rweather/ardpicprog/circuits/pic14_zif_assembled.jpg

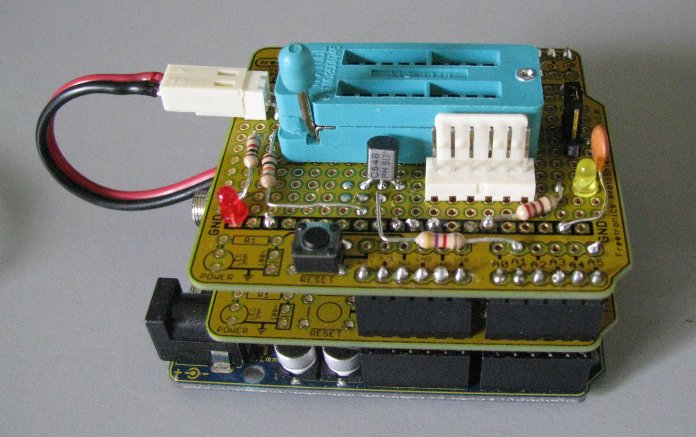
circuits/pic14_zif_assembled.jpg
