rweather/ardpicprog/circuits/eeprom_circuit_inuse.jpg

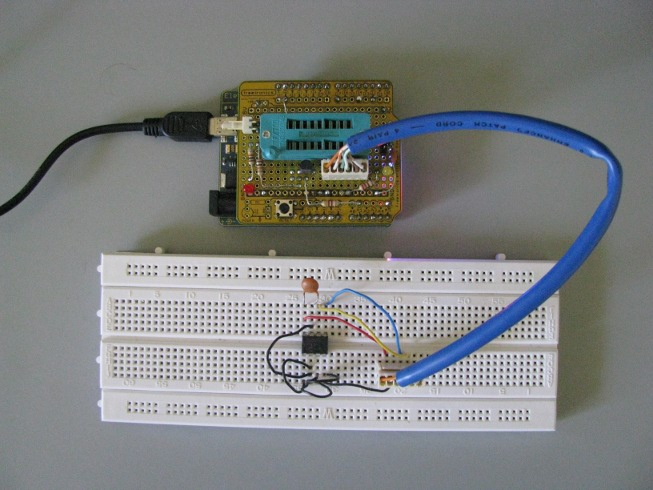
circuits/eeprom_circuit_inuse.jpg
