rweather/ardpicprog/circuits/eeprom_circuit.pdf

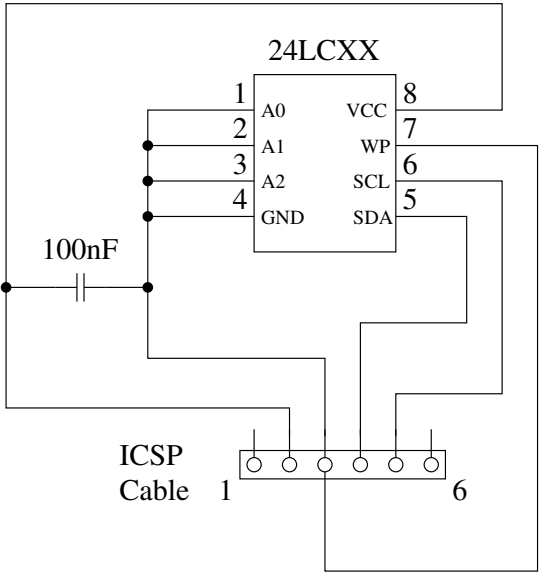
[picture p3: figure]
GND; VCC; SCL; SDA; 24LCXX; ICSP Cable

Description

MCLR/VPP

VDD

VSS

DATA

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
ICSP
