rweather/ardpicprog/circuits/eeprom_circuit.png

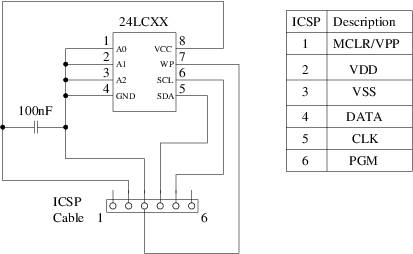
circuits/eeprom_circuit.png
