rweather/ardpicprog/circuits/icsp_circuit.png

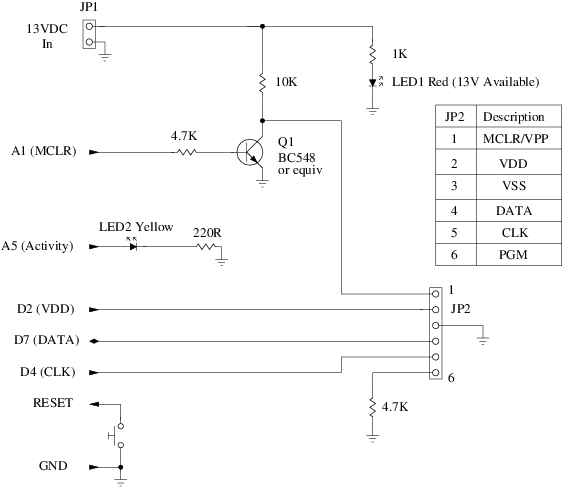
circuits/icsp_circuit.png
