rweather/ardpicprog/circuits/pic14_zif_bottom.jpg

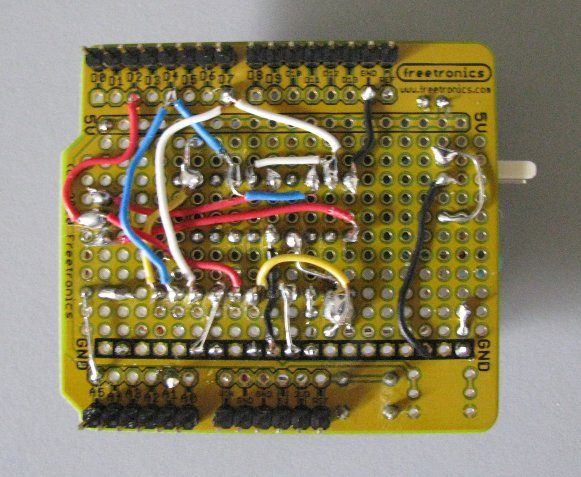
circuits/pic14_zif_bottom.jpg
