rweather/ardpicprog/circuits/pic14_zif_circuit.png

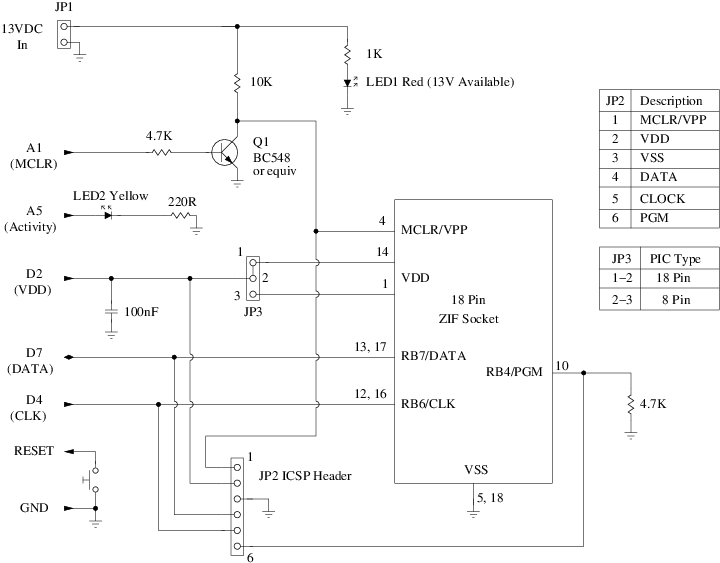
circuits/pic14_zif_circuit.png
