rweather/ardpicprog/circuits/pic14_zif_inuse.jpg

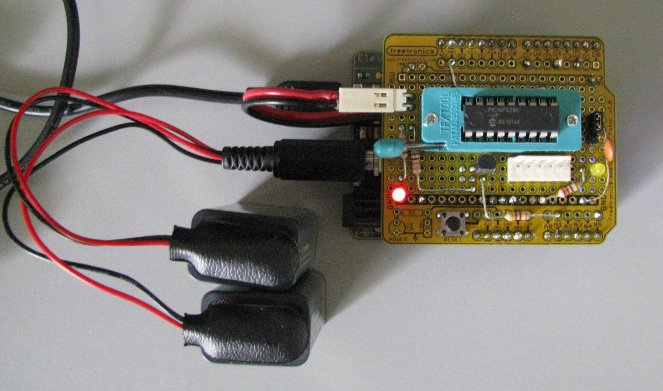
circuits/pic14_zif_inuse.jpg
