rweather/ardpicprog/circuits/pic14_zif_top.jpg

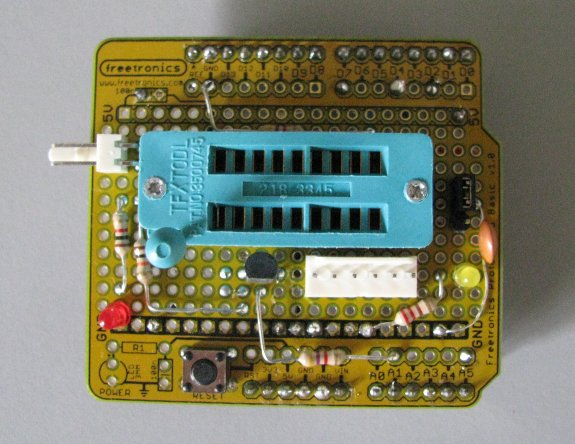
circuits/pic14_zif_top.jpg
