rweather/ardpicprog/circuits/power_supply_batteries.jpg

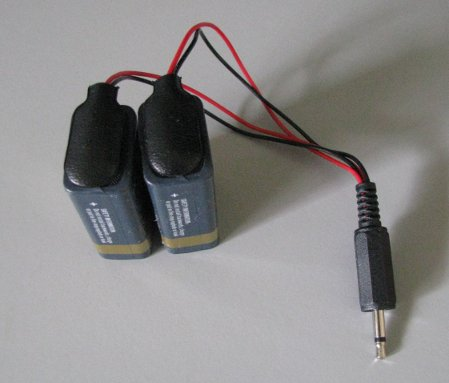
circuits/power_supply_batteries.jpg
