rweather/ardpicprog/circuits/power_supply_bottom.jpg

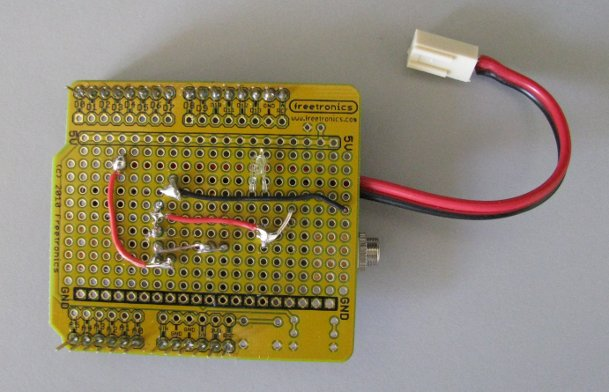
circuits/power_supply_bottom.jpg
