rweather/ardpicprog/circuits/power_supply_circuit.png

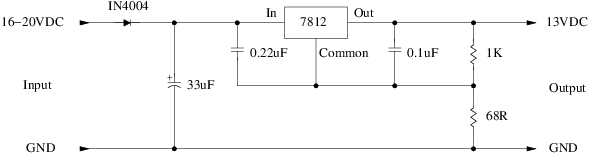
circuits/power_supply_circuit.png
