rweather/ardpicprog/circuits/power_supply_max629.png

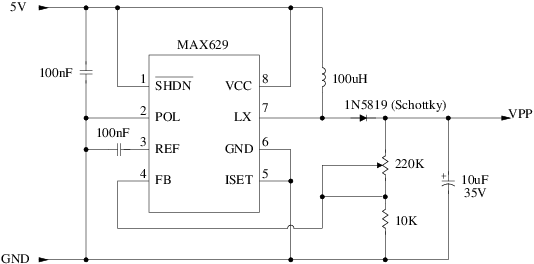
circuits/power_supply_max629.png
