rweather/ardpicprog/circuits/power_supply_mc34063.png

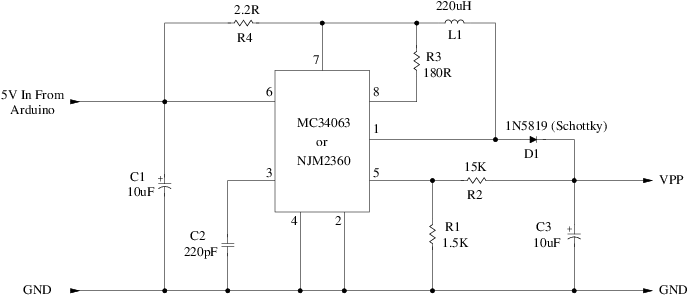
circuits/power_supply_mc34063.png
