rweather/ardpicprog/circuits/power_supply_mc34063_adjustable.png

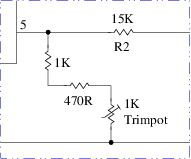
circuits/power_supply_mc34063_adjustable.png
