rweather/ardpicprog/circuits/power_supply_mc34063_breadboard.jpg

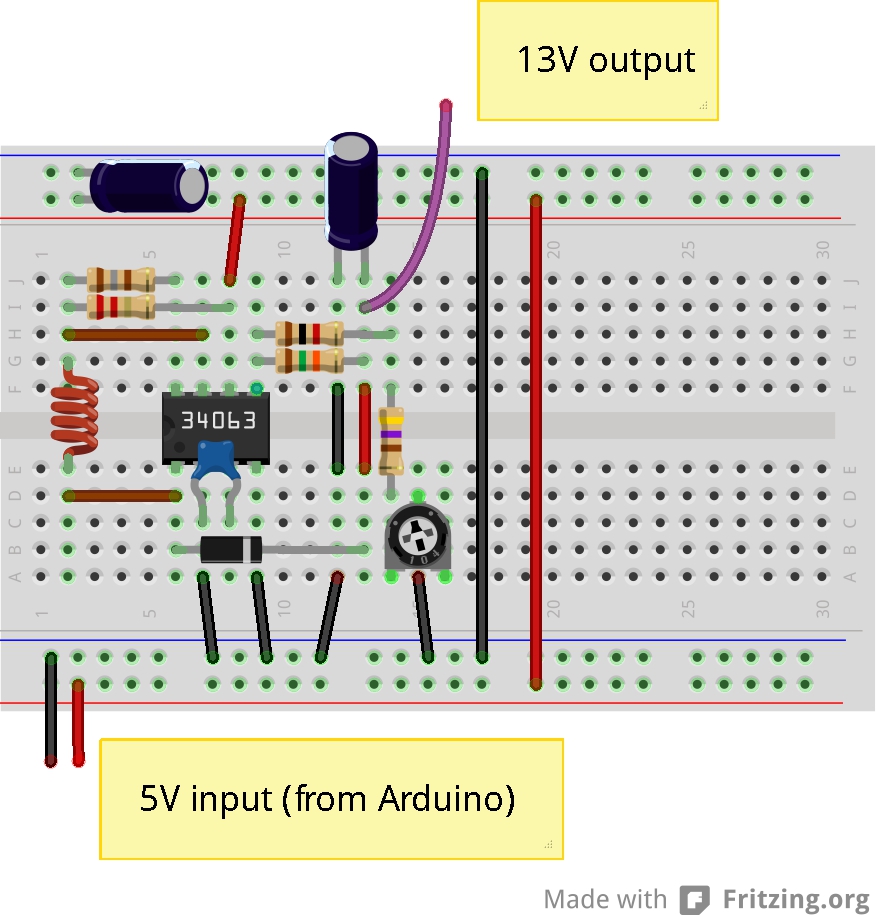
circuits/power_supply_mc34063_breadboard.jpg
