rweather/ardpicprog/circuits/power_supply_top.jpg

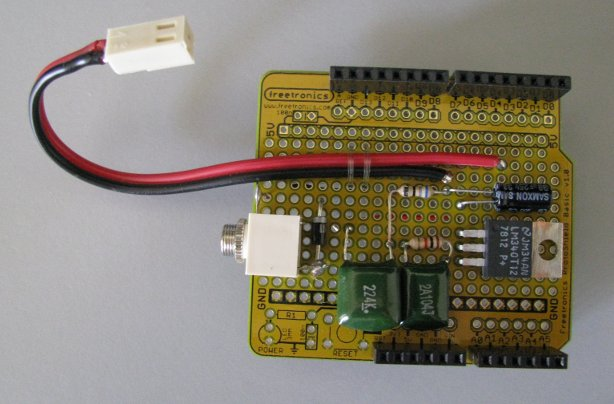
circuits/power_supply_top.jpg
