rweather/ardpicprog/ChangeLog.md

## Change log

### 0.1.1

* Native Win32 version of the serial port code.
* Stub manual page that redirects to the web documentation.
* Install and uninstall rules in the Makefiles.

### 0.1.0

* Initial version with support for common 14-bit PIC devices.
