rweather/ardpicprog/(threads)

Thread 1 (2013-05-05):

error @ arduino 1.0.1

tomaskovacik, 2013-05-05:
ardpicprog.cpp:69:28: error: ‘prog_char’ does not name a type
ardpicprog.cpp:69:39: error: ISO C++ forbids declaration of ‘str’ with no type [-fpermissive]
ardpicprog.cpp:86:24: error: ‘prog_char’ does not name a type
ardpicprog.cpp:86:35: error: ISO C++ forbids declaration of ‘name’ with no type [-fpermissive]
ardpicprog.cpp:144:11: error: ‘prog_char’ does not name a type
ardpicprog.cpp:145:5: error: ‘prog_int16_t’ does not name a type
ardpicprog.cpp:146:5: error: ‘prog_uint32_t’ does not name a type
ardpicprog.cpp:147:5: error: ‘prog_uint32_t’ does not name a type
ardpicprog.cpp:148:5: error: ‘prog_uint32_t’ does not name a type
ardpicprog.cpp:149:5: error: ‘prog_uint16_t’ does not name a type
ardpicprog.cpp:150:5: error: ‘prog_uint16_t’ does not name a type
ardpicprog.cpp:151:5: error: ‘prog_uint16_t’ does not name a type
ardpicprog.cpp:152:5: error: ‘prog_uint16_t’ does not name a type
ardpicprog.cpp:153:5: error: ‘prog_uint8_t’ does not name a type
ardpicprog.cpp:154:5: error: ‘prog_uint8_t’ does not name a type
ardpicprog.cpp:181:1: error: too many initializers for ‘const deviceInfo’
ardpicprog.cpp:181:1: error: too many initializers for ‘const deviceInfo’
ardpicprog.cpp:181:1: error: too many initializers for ‘const deviceInfo’
ardpicprog.cpp:181:1: error: too many initializers for ‘const deviceInfo’
ardpicprog.cpp:181:1: error: too many initializers for ‘const deviceInfo’
ardpicprog.cpp:181:1: error: too many initializers for ‘const deviceInfo’
ardpicprog.cpp:181:1: error: too many initializers for ‘const deviceInfo’
ardpicprog.cpp:181:1: error: too many initializers for ‘const deviceInfo’
ardpicprog.cpp:181:1: error: too many initializers for ‘const deviceInfo’
ardpicprog.cpp:181:1: error: too many initializers for ‘const deviceInfo’
ardpicprog.cpp:181:1: error: too many initializers for ‘const deviceInfo’
ardpicprog.cpp:181:1: error: too many initializers for ‘const deviceInfo’
ardpicprog.cpp:181:1: error: too many initializers for ‘const deviceInfo’
ardpicprog.cpp:181:1: error: too many initializers for ‘const deviceInfo’
ardpicprog.cpp:271:28: error: ‘prog_char’ does not name a type
ardpicprog.cpp:271:39: error: ISO C++ forbids declaration of ‘str’ with no type [-fpermissive]
ardpicprog.cpp: In function ‘void initDevice(const deviceInfo_)’:
ardpicprog.cpp:293:18: error: ‘const struct deviceInfo’ has no member named ‘programSize’
ardpicprog.cpp:294:19: error: ‘const struct deviceInfo’ has no member named ‘configStart’
ardpicprog.cpp:295:31: error: ‘const struct deviceInfo’ has no member named ‘configSize’
ardpicprog.cpp:296:17: error: ‘const struct deviceInfo’ has no member named ‘dataStart’
ardpicprog.cpp:297:27: error: ‘const struct deviceInfo’ has no member named ‘dataSize’
ardpicprog.cpp:298:34: error: ‘const struct deviceInfo’ has no member named ‘reservedWords’
ardpicprog.cpp:300:18: error: ‘const struct deviceInfo’ has no member named ‘configSave’
ardpicprog.cpp:301:21: error: ‘const struct deviceInfo’ has no member named ‘progFlashType’
ardpicprog.cpp:302:21: error: ‘const struct deviceInfo’ has no member named ‘dataFlashType’
ardpicprog.cpp:306:28: error: ISO C++ forbids declaration of ‘type name’ with no type [-fpermissive]
ardpicprog.cpp:306:28: error: ISO C++ forbids declaration of ‘type name’ with no type [-fpermissive]
ardpicprog.cpp:306:22: error: expected primary-expression before ‘const’
ardpicprog.cpp:306:22: error: expected ‘)’ before ‘const’
ardpicprog.cpp:306:41: error: expected ‘;’ before ‘)’ token
ardpicprog.cpp: In function ‘void cmdDevice(const char_)’:
ardpicprog.cpp:393:15: error: ‘prog_char’ does not name a type
ardpicprog.cpp:394:14: error: expected primary-expression before ‘)’ token
ardpicprog.cpp:394:14: error: expected ‘;’ before ‘)’ token
ardpicprog.cpp:395:14: error: ‘name’ was not declared in this scope
ardpicprog.cpp:399:18: error: ‘const struct deviceInfo’ has no member named ‘deviceId’
ardpicprog.cpp: In function ‘void cmdDevices(const char_)’:
ardpicprog.cpp:437:15: error: ‘prog_char’ does not name a type
ardpicprog.cpp:438:14: error: expected primary-expression before ‘)’ token
ardpicprog.cpp:438:14: error: expected ‘;’ before ‘)’ token
ardpicprog.cpp:439:14: error: ‘name’ was not declared in this scope
ardpicprog.cpp:448:25: error: ‘name’ was not declared in this scope
ardpicprog.cpp:449:24: error: ‘const struct deviceInfo’ has no member named ‘deviceId’
ardpicprog.cpp: In function ‘void cmdSetDevice(const char_)’:
ardpicprog.cpp:473:15: error: ‘prog_char’ does not name a type
ardpicprog.cpp:474:14: error: expected primary-expression before ‘)’ token
ardpicprog.cpp:474:14: error: expected ‘;’ before ‘)’ token
ardpicprog.cpp:475:14: error: ‘name’ was not declared in this scope
ardpicprog.cpp:477:25: error: ‘name’ was not declared in this scope
ardpicprog.cpp: In function ‘void cmdWrite(const char_)’:
ardpicprog.cpp:648:48: error: cannot convert ‘const char_’ to ‘const int_’ for argument ‘1’ to ‘bool matchString(const int_, const char_, int)’
ardpicprog.cpp: In function ‘void cmdWriteBinary(const char_)’:
ardpicprog.cpp:736:48: error: cannot convert ‘const char_’ to ‘const int_’ for argument ‘1’ to ‘bool matchString(const int_, const char_, int)’
ardpicprog.cpp: In function ‘void cmdErase(const char_)’:
ardpicprog.cpp:837:57: error: cannot convert ‘const char_’ to ‘const int_’ for argument ‘1’ to ‘bool matchString(const int_, const char_, int)’
ardpicprog.cpp: At global scope:
ardpicprog.cpp:947:11: error: ‘prog_char’ does not name a type
ardpicprog.cpp:949:11: error: ‘prog_char’ does not name a type
ardpicprog.cpp:950:11: error: ‘prog_char’ does not name a type
ardpicprog.cpp:1002:1: error: too many initializers for ‘const command_t’
ardpicprog.cpp:1002:1: error: too many initializers for ‘const command_t’
ardpicprog.cpp:1002:1: error: too many initializers for ‘const command_t’
ardpicprog.cpp:1002:1: error: too many initializers for ‘const command_t’
ardpicprog.cpp:1002:1: error: too many initializers for ‘const command_t’
ardpicprog.cpp:1002:1: error: too many initializers for ‘const command_t’
ardpicprog.cpp:1002:1: error: too many initializers for ‘const command_t’
ardpicprog.cpp:1002:1: error: too many initializers for ‘const command_t’
ardpicprog.cpp:1002:1: error: too many initializers for ‘const command_t’
ardpicprog.cpp:1002:1: error: too many initializers for ‘const command_t’
ardpicprog.cpp:1002:1: error: too many initializers for ‘const command_t’
ardpicprog.cpp:1002:1: error: too many initializers for ‘const command_t’
ardpicprog.cpp:1002:1: error: cannot convert ‘const char_’ to ‘commandFunc {aka void (_)(const char_)}’ in initialization
ardpicprog.cpp:1002:1: error: cannot convert ‘const char_’ to ‘commandFunc {aka void (_)(const char_)}’ in initialization
ardpicprog.cpp:1002:1: error: cannot convert ‘const char_’ to ‘commandFunc {aka void (_)(const char_)}’ in initialization
ardpicprog.cpp:1002:1: error: cannot convert ‘const char_’ to ‘commandFunc {aka void (_)(const char_)}’ in initialization
ardpicprog.cpp:1002:1: error: cannot convert ‘const char_’ to ‘commandFunc {aka void (_)(const char_)}’ in initialization
ardpicprog.cpp:1002:1: error: cannot convert ‘const char_’ to ‘commandFunc {aka void (_)(const char_)}’ in initialization
ardpicprog.cpp:1002:1: error: cannot convert ‘const char_’ to ‘commandFunc {aka void (_)(const char_)}’ in initialization
ardpicprog.cpp:1002:1: error: cannot convert ‘const char_’ to ‘commandFunc {aka void (_)(const char_)}’ in initialization
ardpicprog.cpp:1002:1: error: cannot convert ‘const char_’ to ‘commandFunc {aka void (_)(const char_)}’ in initialization
ardpicprog.cpp:1002:1: error: cannot convert ‘const char_’ to ‘commandFunc {aka void (_)(const char_)}’ in initialization
ardpicprog.cpp:1002:1: error: cannot convert ‘const char_’ to ‘commandFunc {aka void (_)(const char_)}’ in initialization
ardpicprog.cpp: In function ‘void cmdHelp(const char_)’:
ardpicprog.cpp:1010:15: error: ‘prog_char’ does not name a type
ardpicprog.cpp:1011:14: error: expected primary-expression before ‘)’ token
ardpicprog.cpp:1011:14: error: expected ‘;’ before ‘)’ token
ardpicprog.cpp:1012:14: error: ‘name’ was not declared in this scope
ardpicprog.cpp:1014:15: error: ‘prog_char’ does not name a type
ardpicprog.cpp:1015:14: error: expected primary-expression before ‘)’ token
ardpicprog.cpp:1015:14: error: expected ‘;’ before ‘)’ token
ardpicprog.cpp:1016:15: error: ‘prog_char’ does not name a type
ardpicprog.cpp:1017:14: error: expected primary-expression before ‘)’ token
ardpicprog.cpp:1017:14: error: expected ‘;’ before ‘)’ token
ardpicprog.cpp:1018:25: error: ‘name’ was not declared in this scope
ardpicprog.cpp:1021:33: error: cannot convert ‘const char_’ to ‘const int_’ for argument ‘1’ to ‘void printProgString(const int_)’
ardpicprog.cpp:1025:25: error: ‘desc’ was not declared in this scope
ardpicprog.cpp: At global scope:
ardpicprog.cpp:1033:24: error: ‘prog_char’ does not name a type
ardpicprog.cpp:1033:35: error: ISO C++ forbids declaration of ‘name’ with no type [-fpermissive]
ardpicprog.cpp: In function ‘void processCommand(const char*)’:
ardpicprog.cpp:1082:15: error: ‘prog_char’ does not name a type
ardpicprog.cpp:1083:14: error: expected primary-expression before ‘)’ token
ardpicprog.cpp:1083:14: error: expected ‘;’ before ‘)’ token
ardpicprog.cpp:1084:14: error: ‘name’ was not declared in this scope
ardpicprog.cpp:1086:25: error: ‘name’ was not declared in this scope

Closed 2018-08-30.

Thread 6 (2017-06-16):

Arduino 1.6.8 'prog_char' does not name a type

EnriqueMT92, 2017-06-16:
I am trying to compile the arduino pic programmer program and it gives me this error
'prog_char' does not name a type

adlerweb, 2018-02-10:
Duplicate of #1

Thread 8 (2019-08-05):

How to add devices?

TheFax, 2019-08-05:
It seems that this project, despite being the best, is no longer under development.

I would like to ask you, if you can **explain us how to add a new device**.
For example I'm interested in:
16f84a
16f876a
16f877a

Thank you in advance.

RusB, 2019-08-11:
Read the DeviceDoc.
Add info about a device in the "struct deviceInfo const devices[]"
Already in the "devices[]":
const char s_pic16f84[]   PROGMEM = "pic16f84";
const char s_pic16f84a[]  PROGMEM = "pic16f84a";
const char s_pic16f87[]   PROGMEM = "pic16f87";
const char s_pic16f88[]   PROGMEM = "pic16f88";

Thread 9 (2019-09-30):

[question]read out hex file which is fill with 0x3FFF

skcks, 2019-09-30:
I trying to read out hex from pic16f887,but get nothing except 0x3FFF；

**23:42:57.649 -> OK
23:42:57.649 -> DeviceID: 2082
23:42:57.649 -> DeviceName: pic16f887
23:42:57.684 -> ProgramRange: 0000-1FFF
23:42:57.719 -> ConfigRange: 2000-2008
23:42:57.719 -> DataRange: 2100-21FF
23:42:57.753 -> ConfigWord: 3FFF
23:42:57.753 -> .**

./ardpicprog -d pic16f887  -p /dev/ttyS5 -o pic.hex
/dev/ttyACM0
Ardpicprog version 0.1.2, Copyright (c) 2012 Southern Storm Pty Ltd.
Ardpicprog comes with ABSOLUTELY NO WARRANTY; for details
type `ardpicprog --warranty'.  This is free software,
and you are welcome to redistribute it under certain conditions;
type `ardpicprog --copying' for details.

Initializing programmer ...
Device pic16f887, program memory: 8192 words, data memory: 256 bytes.
Reading program memory,
reading data memory,
reading id words and fuses,
done.

[pic.zip](https://github.com/rweather/ardpicprog/files/3672106/pic.zip)

rweather, 2019-09-30:
There are two possibilities that I can think of.

The first is that you haven't programmed the chip yet.  The default for flash memory is for bits to be in the 1 state - they can only become 0 when programmed.  You may simply be reading the default memory contents.

The second is that the Arduino is not communicating with the chip properly - the data line is somehow being pulled high and so it only ever reads 1 bits.  Check the programming voltage and the ICSP connections.

Thread 10 (2019-10-16):

Issue writing contents of config memory

osvathrobi, 2019-10-16:
Here is my output. Everything seems to be fine except I get an error when writing config memory on a Pic16F630. I'm a bit new to PIC programming.

```
Initialising programmer ...
Device pic16f630, program memory: 1024 words, data memory: 128 bytes.
Erasing and removing code protection.
Burning program memory, 772 locations,
burning data memory, 1 location,
burning id words and fuses,Write to device failed
```

tomaskovacik, 2019-10-16:
try programed pic

maybe it is fine, on my 12f629 ardpicprog also failed for last step and all works fine:

from email communication with Rhys:

    I have another problem:
     "burning id words and fuses,Write to device failed"

It depends.  I sometimes see that because the read-back doesn't work properly on the config word, or the device hasn't been properly erased.  It's PIC-specific - not all of them do it.  I suggest reading the contents off the PIC and comparing.  If the config word looks OK, you can safely ignore it.

osvathrobi, 2019-10-16:
Thank you. I didn't actually test the chip, thought the write failed. But I went ahead, tested it and it was working properly. So the burn was indeed successful. However the error comes up every time I write.

rweather, 2019-10-17:
This issue is likely due to the OSCCAL bits in the configuration word.  The ProgramPIC sketch takes care not to overwrite them, but then when the read back occurs, the value you asked to write to the config word doesn't match because those bits have changed between your hex file and the actual written value.

Simplest workaround is to read the actual OSCCAL bits from your chip and add those exact bit values to the configuration word in your PIC program.  The next time you write, the configuration word will match and it will stop complaining.

osvathrobi, 2019-10-17:
Thank you for the clarification. Maybe useful for beginners - if the error message could give a softer error or some mention towards this. (If the other write sequences were correct) Either way thank you for the tool, it came in very handy to mod a SNES with SuperCiC fw.

Closed 2019-10-18.

Thread 11 (2022-01-30):

Issue writing data memory

Jerby13, 2022-01-30:
I have issue with flashing OTGW 5.2.
 .\PicProgHost -p COM3 --erase --burn -i gateway.hex --force-calibration

Initializing programmer ...
Device pic16f88, program memory: 4096 words, data memory: 256 bytes.
Erasing and removing code protection.
Burning program memory, 3991 locations,
burning data memory,Write to device failed
