rweather/ardpicprog/circuits/power_supply_circuit.pdf

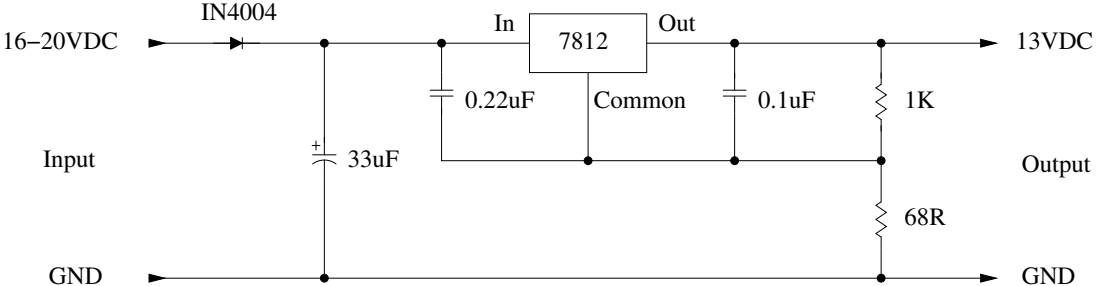
[picture p18: page 1]
Out; 0.1uF Common; 13VDC; GND; Output; Input; 16−20VDC
