rweather/ardpicprog/circuits/icsp_circuit.pdf

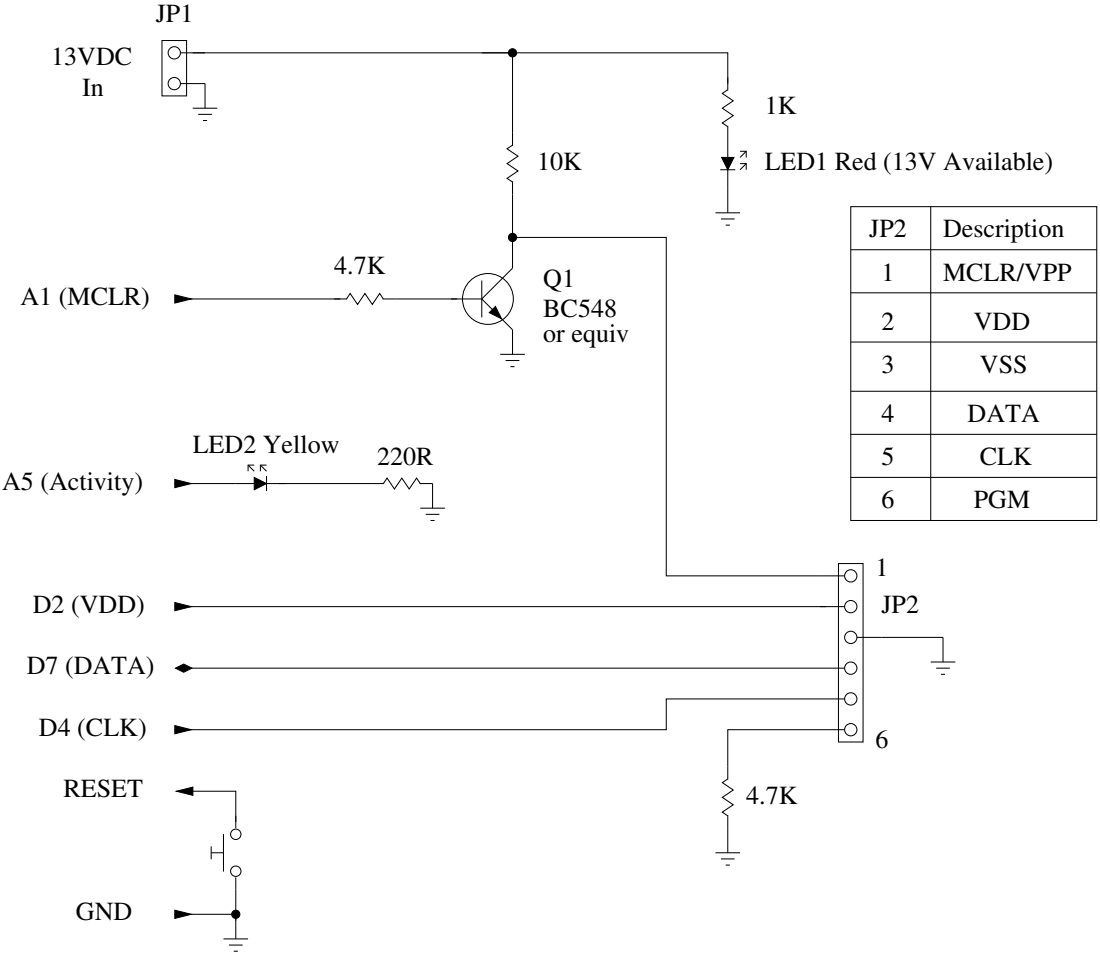
[picture p19: page 1]
