rweather/ardpicprog/circuits/pic14_zif_circuit.pdf

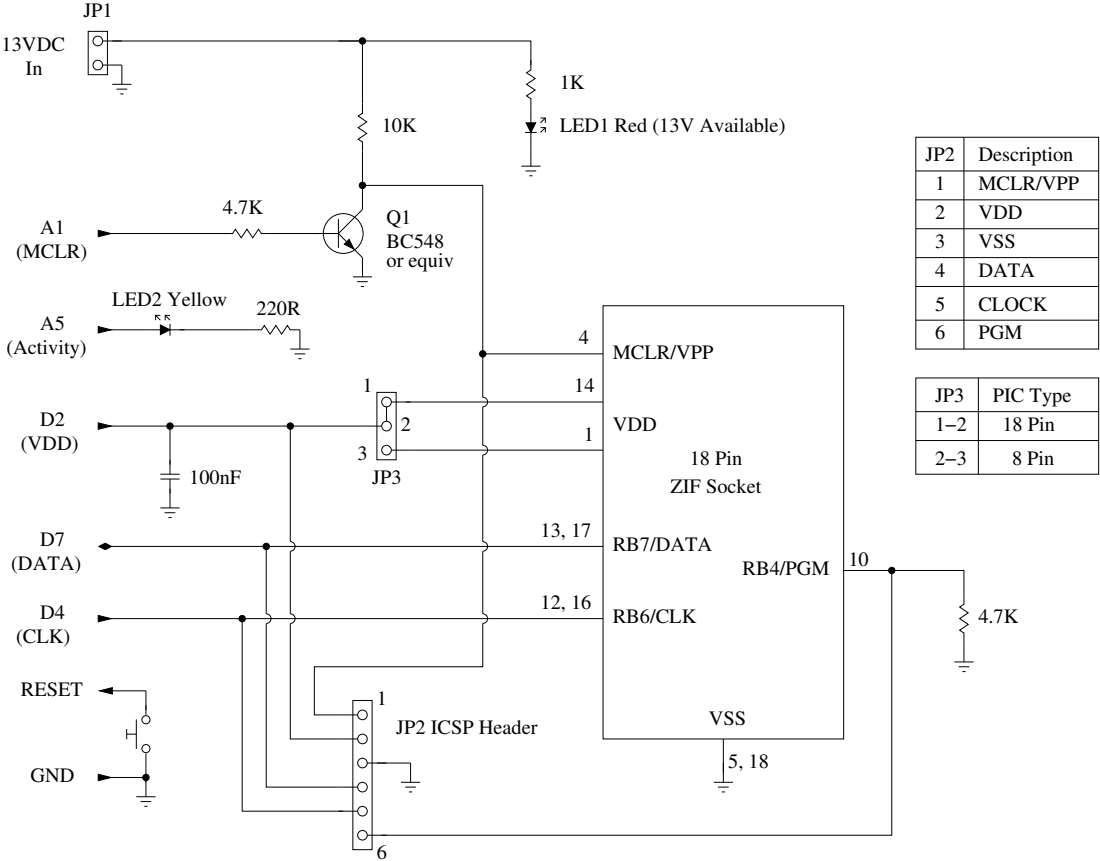
[picture p20: page 1]
