rweather/ardpicprog/(commit log)

2012-04-21 Arduino side of the PIC programming protocol
2012-04-22 Add circuits and descriptions to the source tree
2012-04-23 Fix reporting of config word
    [ProgramPIC.pde]
2012-04-25 Add a protection diode to the power supply circuit
2012-04-27 Supported device list
2012-04-27 Document current draw from 13v supply
2012-04-28 Simplify power supply circuit diagram
2012-04-28 Fix some device-specific issues in ProgramPIC
    PIC12F629 and family need some bits in the configuration word
    preserved when the chip is erased.
    PIC16F628A has 256 bytes of EEPROM, not 128
    [ProgramPIC.pde]
2012-04-28 Adjust activity LED blink rate for writing
2012-05-29 Fix a problem with erasing PIC12F675/629
    Delay between bulk erase of program and data memory was too long,
    which made it impossible to reset the configuration word.
    [ProgramPIC.pde]
2012-05-29 Better handling for --force-calibration in the host
2012-10-07 Alternative VPP power supply using MAX629
2013-05-05 Quick fix for compile issue with Arduino 1.x
    PROGMEM types are no different. Enable compatibility until a
    better solution can be implemented.
    [ProgramPIC.pde]
2013-07-20 13V step up circuit from Valter Fukuoka
2013-07-26 Fix misnamed devices: PIC12F630/676 -> PIC16F630/676
    [ProgramPIC.pde]
